aayanrahman/Star-Notifier/Star-Notifier.kicad_pcb

## KiCad design Star-Notifier.kicad_pcb (2026-10-26)

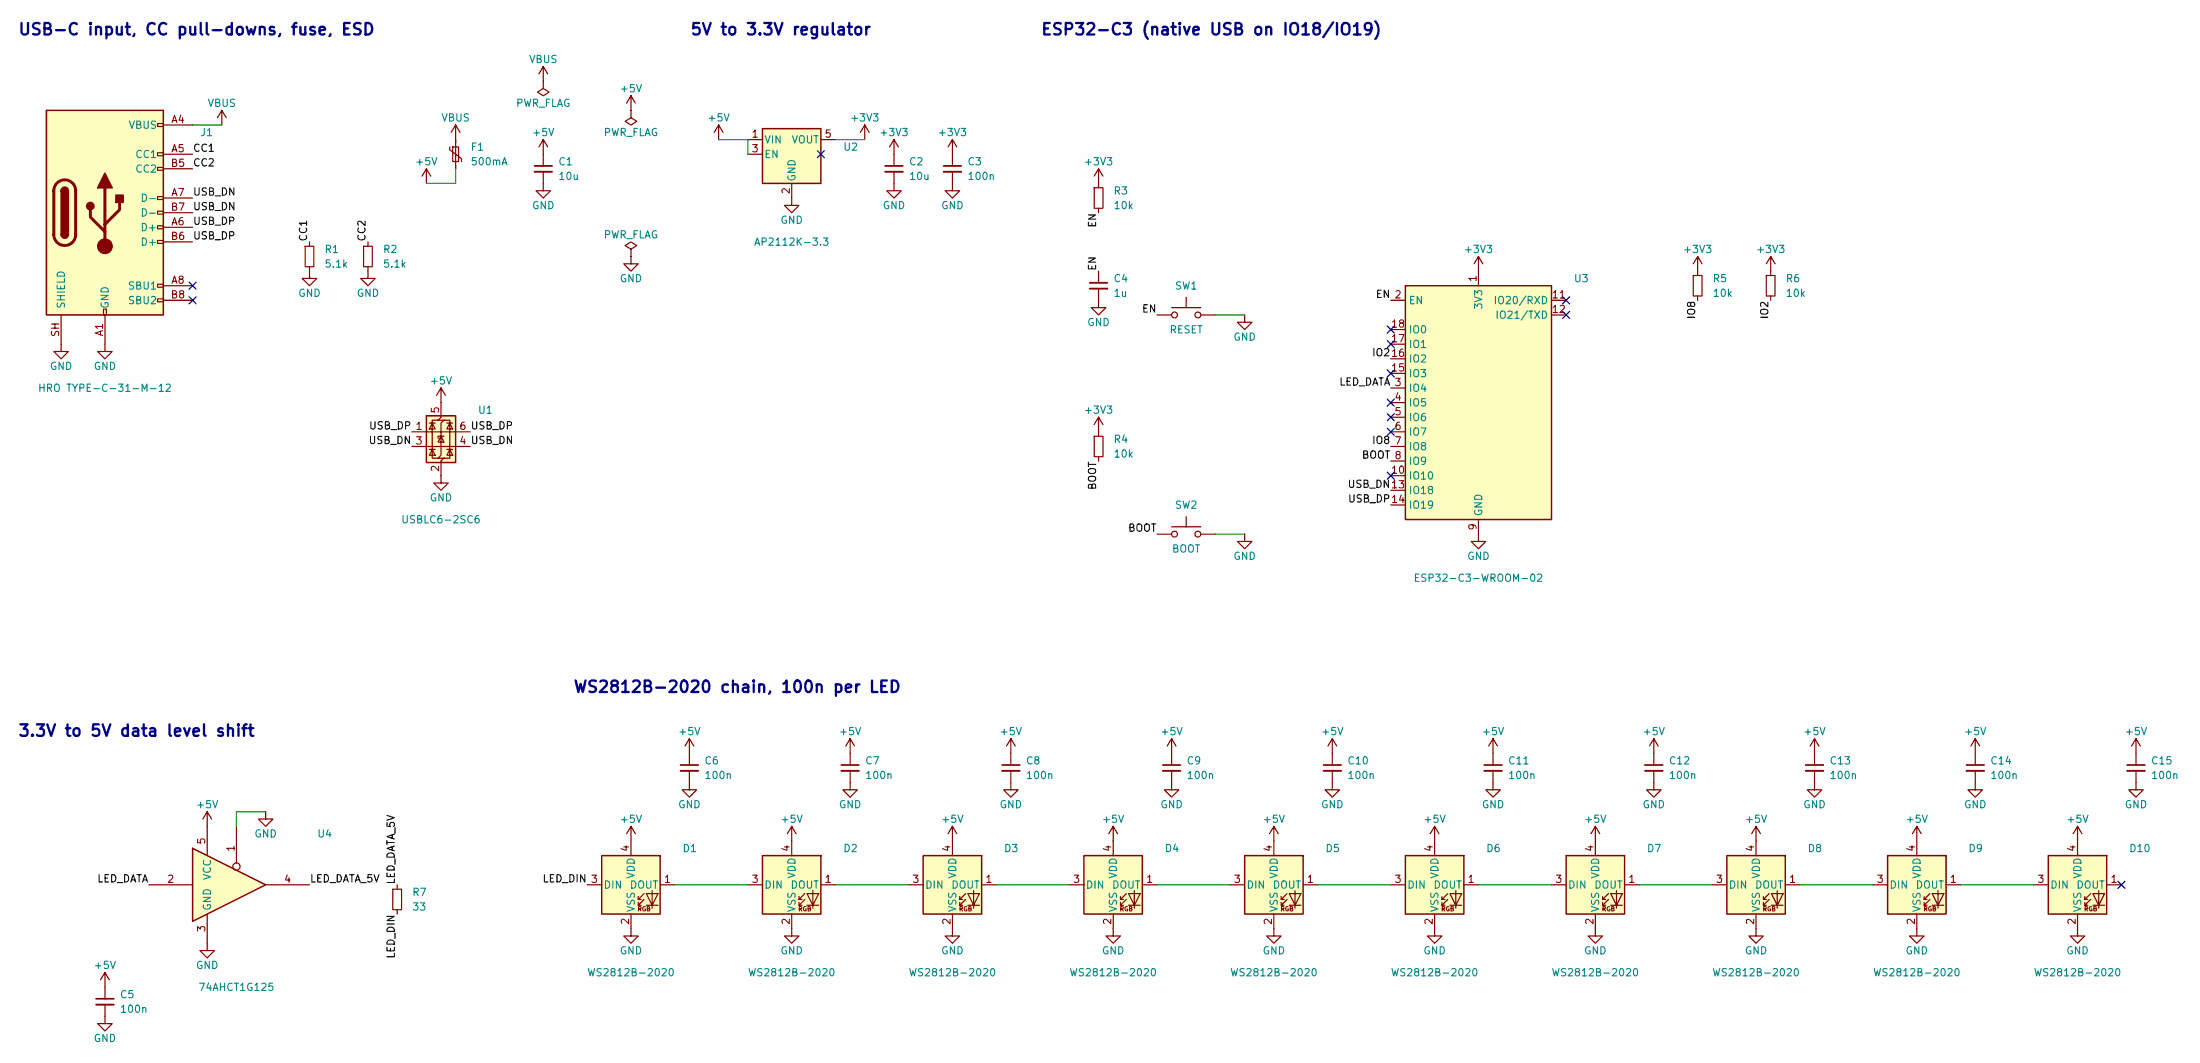
[picture p1: schematic Star-Notifier.kicad_sch, Star Notifier]

Parts:
C1, C2: 10u; C_0805_2012Metric
C3, C5, C6, C7, C8, C9, C10, C11, C12, C13, C14, C15: 100n; C_0603_1608Metric
C4: 1u; C_0603_1608Metric
D1, D2, D3, D4, D5, D6, D7, D8, D9, D10: WS2812B-2020; LED_WS2812B-2020_PLCC4_2.0x2.0mm
F1: 500mA; Fuse_1206_3216Metric
J1: HRO TYPE-C-31-M-12; USB_C_Receptacle_HRO_TYPE-C-31-M-12
R1, R2: 5.1k; R_0603_1608Metric
R3, R4, R5, R6: 10k; R_0603_1608Metric
R7: 33; R_0603_1608Metric
SW1: RESET; SW_Push_1P1T_XKB_TS-1187A
SW2: BOOT; SW_Push_1P1T_XKB_TS-1187A
U1: USBLC6-2SC6; SOT-23-6
U2: AP2112K-3.3; SOT-23-5
U3: ESP32-C3-WROOM-02
U4: 74AHCT1G125; SOT-23-5

Connections:
+3V3: C2.1, C3.1, R3.1, R4.1, R5.1, R6.1, U2.5 (VOUT), U3.1 (3V3)
+5V: C1.1, C5.1, C6.1, C7.1, C8.1, C9.1, C10.1, C11.1, C12.1, C13.1, C14.1, C15.1, D1.4 (VDD), D2.4 (VDD), D3.4 (VDD), D4.4 (VDD), D5.4 (VDD), D6.4 (VDD), D7.4 (VDD), D8.4 (VDD), D9.4 (VDD), D10.4 (VDD), F1.2, U1.5 (VBUS), U2.1 (VIN), U2.3 (EN), U4.5 (VCC)
/BOOT: R4.2, SW2.1, U3.8 (IO9)
/CC1: J1.A5 (CC1), R1.1
/CC2: J1.B5 (CC2), R2.1
/EN: C4.1, R3.2, SW1.1, U3.2 (EN)
/IO2: R6.2, U3.16 (IO2)
/IO8: R5.2, U3.7 (IO8)
/LED_DATA: U3.3 (IO4), U4.2
/LED_DATA_5V: R7.1, U4.4
/LED_DIN: D1.3 (DIN), R7.2
/USB_DN: J1.A7 (D-), J1.B7 (D-), U1.3 (I/O2), U1.4 (I/O2), U3.13 (IO18)
/USB_DP: J1.A6 (D+), J1.B6 (D+), U1.1 (I/O1), U1.6 (I/O1), U3.14 (IO19)
GND: C1.2, C2.2, C3.2, C4.2, C5.2, C6.2, C7.2, C8.2, C9.2, C10.2, C11.2, C12.2, C13.2, C14.2, C15.2, D1.2 (VSS), D2.2 (VSS), D3.2 (VSS), D4.2 (VSS), D5.2 (VSS), D6.2 (VSS), D7.2 (VSS), D8.2 (VSS), D9.2 (VSS), D10.2 (VSS), J1.A1 (GND), J1.A12 (GND), J1.B1 (GND), J1.B12 (GND), J1.SH (SHIELD), R1.2, R2.2, SW1.2, SW2.2, U1.2 (GND), U2.2 (GND), U3.9 (GND), U3.19 (GND), U4.1, U4.3 (GND)
unnamed: D1.1 (DOUT), D2.3 (DIN)
unnamed: D2.1 (DOUT), D3.3 (DIN)
unnamed: D3.1 (DOUT), D4.3 (DIN)
unnamed: D4.1 (DOUT), D5.3 (DIN)
unnamed: D5.1 (DOUT), D6.3 (DIN)
unnamed: D6.1 (DOUT), D7.3 (DIN)
unnamed: D7.1 (DOUT), D8.3 (DIN)
unnamed: D8.1 (DOUT), D9.3 (DIN)
unnamed: D9.1 (DOUT), D10.3 (DIN)
VBUS: F1.1, J1.A4 (VBUS), J1.A9 (VBUS), J1.B4 (VBUS), J1.B9 (VBUS)

Notes on the sheet:
WS2812B-2020 chain, 100n per LED
3.3V to 5V data level shift
5V to 3.3V regulator
USB-C input, CC pull-downs, fuse, ESD
ESP32-C3 (native USB on IO18/IO19)

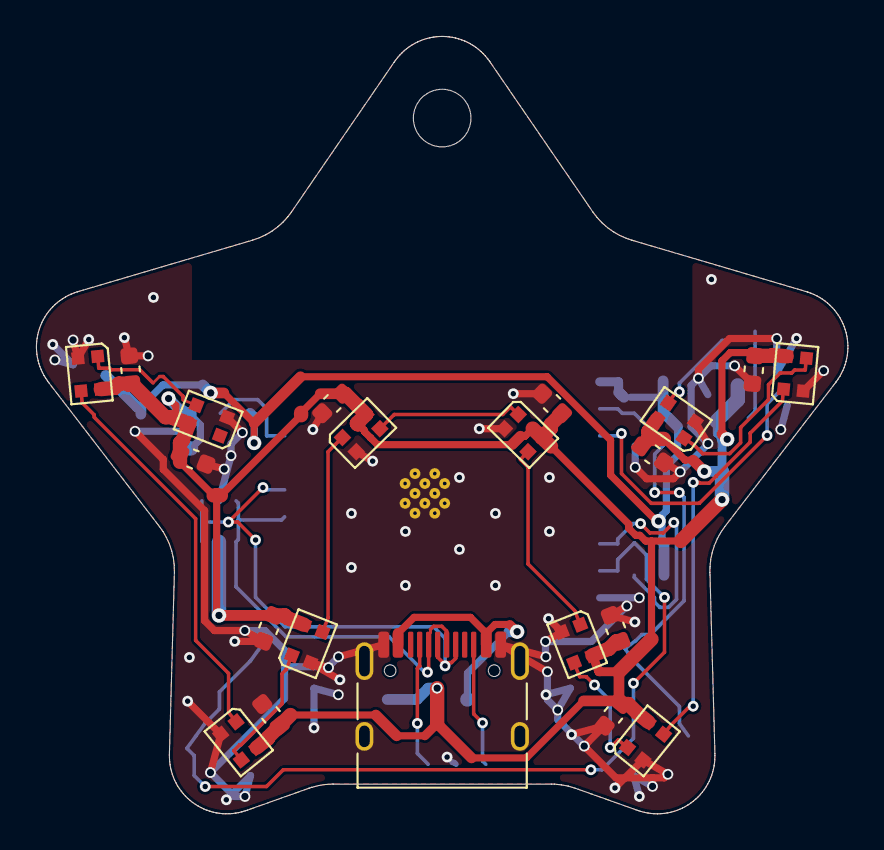
[picture p2: board Star-Notifier.kicad_pcb from above]

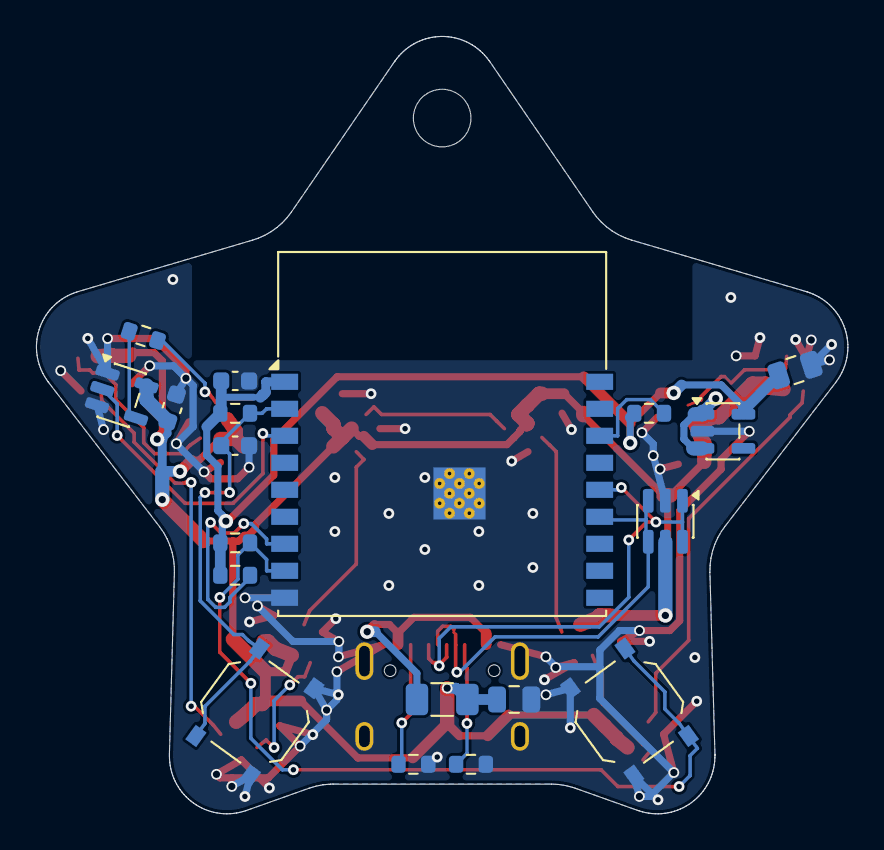
[picture p3: board Star-Notifier.kicad_pcb from below]

Board: 2 copper layers, 45.1 x 43.2 mm, 40 parts (19 on the bottom side), 24 nets.
