aayanrahman/Star-Notifier/(commit log)

2026-10-25 Star Notifier schematic: USB-C, ESP32-C3-WROOM-02, WS2812B-2020 chain
    [Star-Notifier.kicad_sch]
2026-10-25 Add README and ignore KiCad local history
2026-10-26 Star-shaped 2-layer PCB, autorouted
    - Rounded 5-point star outline (~50x47 mm) with a flat bottom for USB-C
    - ESP32-C3-WROOM-02 on the back, antenna in the top arm with keep-out
    - 10 WS2812B LEDs + decoupling on the front, support parts on the back
    - Freerouting signal routing; power widened to 0.5-0.8 mm
    - GND pours on both layers with fanout and stitching vias
    - Net classes/rules at 0.15 mm clearance, 0.2 mm min drill
    - autoroute-scripts/: the placement/route/pour pipeline used
    Known: C1 GND pad is an isolated pour island (1 DRC unconnected);
    silkscreen overlaps not yet cleaned up.
    [Star-Notifier.kicad_pcb]
2026-10-26 Move C1 next to F1 so its GND pad joins the main pour
    C1's GND pad sat in a B.Cu pocket sealed off by the USB pair, leaving
    an isolated pour island. It now sits beside F1's +5V pad with a short
    0.6 mm link; DRC reports no unconnected items.
    [Star-Notifier.kicad_pcb]
2026-10-26 Add keychain hole in the top arm; hide silk reference designators
    - 3.2 mm Edge.Cuts cutout at the top tip, clear of the antenna keep-out
    - Refs were 0.6 mm (below fab silk minimum) and overlapping; now hidden
    on silk (still visible on Fab layers / in KiCad)
    DRC: 0 errors, 0 unconnected; 2 warnings for the USB-C edge silk marks.
    [Star-Notifier.kicad_pcb]
